rdunlop/uni-timer/easyEDA/schematic.pdf

## MicroSD

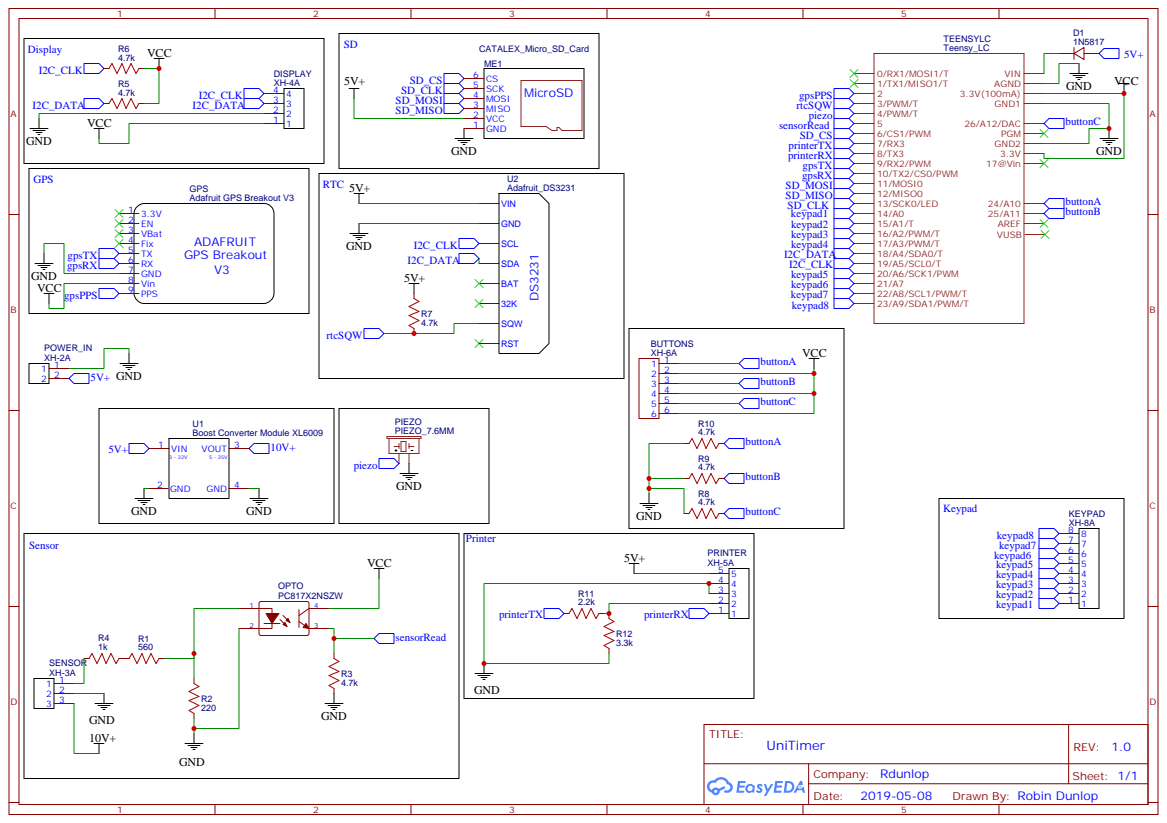
[picture p5: page 1]

Drawn By: Robin Dunlop
