rdunlop/uni-timer/LaserCutBox/Laid out for CuttingTextToPaths.pdf

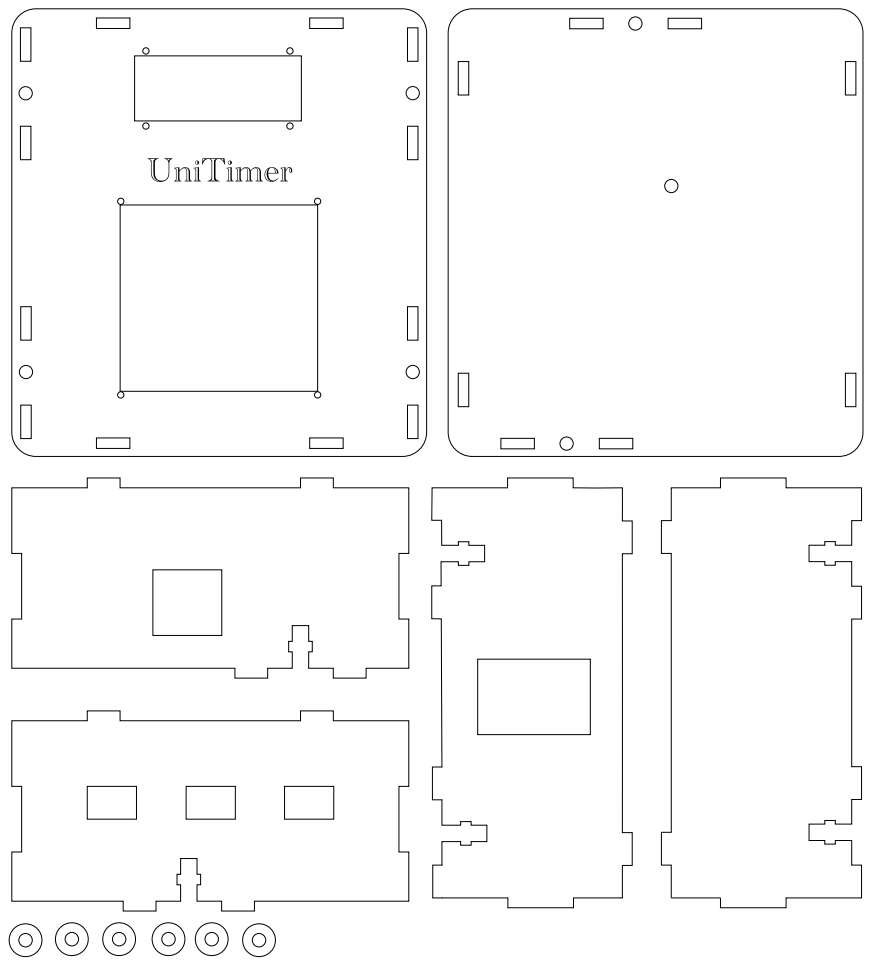
[picture p6: page 1]
