rdunlop/uni-timer/easyEDA/pcb_layout.pdf

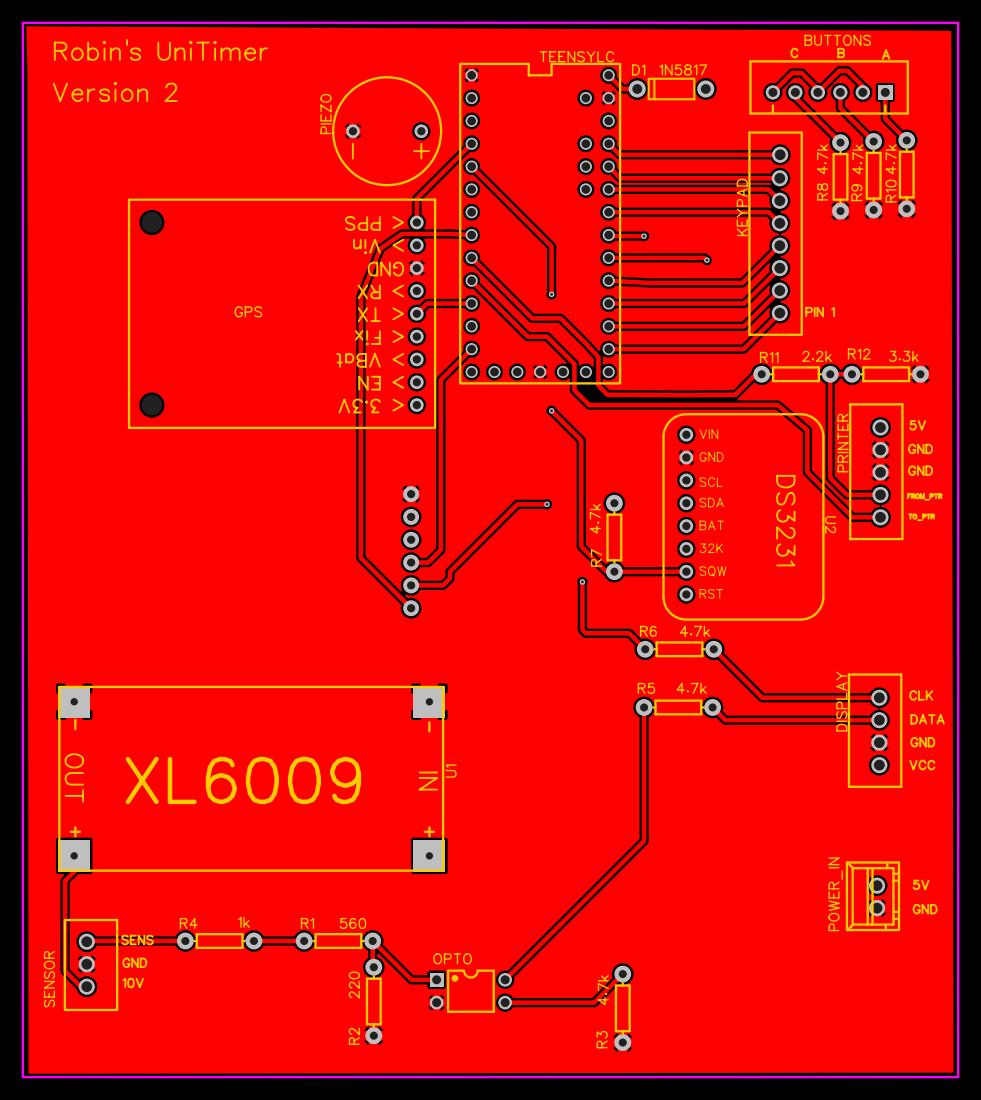
[picture p7: page 1]
