rdunlop/uni-timer/(list of files, drawings)

Other design files:
easyEDA/pcb_layout.json
easyEDA/schematic.json
