rdunlop/uni-timer/rtc.ino

// - RTC
#ifdef ENABLE_RTC
#include "RTClib.h"

RTC_DS3231 rtc;

volatile byte rtc_interrupt_flag = false;
volatile unsigned long rtc_start_ms = micros();

uint32_t last_rtc_print_time = millis();

// RTC SQW signal is an active-low signal, so it needs INPUT_PULLUP
void rtc_interrupt(){
  rtc_interrupt_flag = true;
  Serial.print("RTC: ");
  unsigned long  now = micros();
  Serial.println(now - rtc_start_ms);
  rtc_start_ms = now;
}

void setup_rtc() {
  if (! rtc.begin()) {
    Serial.println("Couldn't find RTC");
    while (1);
  }
  if (rtc.lostPower()) {
    Serial.println("RTC lost power, lets set the time!");
    // following line sets the RTC to the date & time this sketch was compiled
    rtc.adjust(DateTime(F(__DATE__), F(__TIME__)));
  }
  // I don't know if this does anything
  // enable the 1 Hz output
  //rtc.writeSqwPinMode (DS3231_SquareWave1Hz);

  pinMode(RTC_SQW_DIGITAL_INPUT, INPUT_PULLUP);
  attachInterrupt(digitalPinToInterrupt(RTC_SQW_DIGITAL_INPUT), rtc_interrupt, RISING);
}

void loop_rtc() {
  if (rtc_interrupt_flag) {
    digitalWrite(LED_BUILTIN, HIGH);    // flash the led
    delay(100);                         // wait a little bit
    digitalWrite(LED_BUILTIN, LOW);     // turn off led
    rtc_interrupt_flag =  false;                      // clear the flag until timer sets it again
  }

  // if millis() or timer wraps around, we'll just reset it
  if (last_rtc_print_time > millis())  last_rtc_print_time = millis();
  // approximately every 2 seconds or so, print out the current GPS stats
  if (millis() - last_rtc_print_time > 2000) { 
    last_rtc_print_time = millis(); // reset the timer
    printRTC();
  }
}

char daysOfTheWeek[7][12] = {"Sunday", "Monday", "Tuesday", "Wednesday", "Thursday", "Friday", "Saturday"};
void printRTC() {
  DateTime now = rtc.now();

  Serial.println("---------------------------");
  Serial.println("RTC:");
  Serial.print(now.year(), DEC);
  Serial.print('/');
  Serial.print(now.month(), DEC);
  Serial.print('/');
  Serial.print(now.day(), DEC);
  Serial.print(" (");
  Serial.print(daysOfTheWeek[now.dayOfTheWeek()]);
  Serial.print(") ");
  Serial.print(now.hour(), DEC);
  Serial.print(':');
  Serial.print(now.minute(), DEC);
  Serial.print(':');
  Serial.print(now.second(), DEC);
  Serial.println();
  
  Serial.print(" since midnight 1/1/1970 = ");
  Serial.print(now.unixtime());
  Serial.print("s = ");
  Serial.print(now.unixtime() / 86400L);
  Serial.println("d");
  
  // calculate a date which is 7 days and 30 seconds into the future
  DateTime future (now + TimeSpan(7,12,30,6));
  
  Serial.print(" now + 7d + 30s: ");
  Serial.print(future.year(), DEC);
  Serial.print('/');
  Serial.print(future.month(), DEC);
  Serial.print('/');
  Serial.print(future.day(), DEC);
  Serial.print(' ');
  Serial.print(future.hour(), DEC);
  Serial.print(':');
  Serial.print(future.minute(), DEC);
  Serial.print(':');
  Serial.print(future.second(), DEC);
  Serial.println();
  
  Serial.println();
}

#endif
