rdunlop/uni-timer/mode_fsm.h

#pragma once

#define MODE_OFFSET 100
#define MODE_1 101
#define MODE_2 102
#define MODE_3 103
#define MODE_4 104
#define MODE_RESUME_5 105
#define MODE_RESUME_6 106
#define MODE_5 107
#define MODE_6 108
#define MODE_GPS_LOCK 109
