rdunlop/uni-timer/modes.h

#pragma once

void mode1_loop();

void mode2_loop();

void mode3_loop();

void mode4_setup();
void mode4_loop();
void mode4_teardown();

void mode5_fsm_setup();
void mode5_setup();
void mode5_loop();
void mode5_teardown();

void mode6_fsm_setup();
void mode6_setup();
void mode6_loop();
void mode6_teardown();

void mode_resume_setup();
void mode_resume_loop();
void mode_resume_teardown();
