rdunlop/uni-timer/(commit log)

2019-05-04 Add Printer, make led blink on sensor read
2019-05-18 Many changes for supporting the full-pin-layout
2019-05-20 Fix Keypad library extraction
    [UniTimer.ino, uni_keypad.cpp, uni_keypad.h]
2019-05-20 extract printer class
2019-06-09 invert the display pinout. Clean up loop codes
    [UniTimer.ino, uni_gps.cpp, uni_gps.h, uni_keypad.cpp, uni_keypad.h, uni_sd.cpp]
2019-06-30 Add lots of display-related code/fixes
    [UniTimer.ino, uni_display.cpp, uni_display.h, uni_keypad.cpp, uni_keypad.h, uni_sd.cpp]
2019-07-01 Create method to read current time, including milliseconds.
2019-07-04 add more FSM code Able to transition to 'sensor ready' mode.
2019-07-04 show racer number and time on printer when in Mode 5
2019-07-05 Attempt to fix the mode-change stuffs
    [UniTimer.ino, uni_keypad.cpp]
2019-07-06 Fix mode-selection with multi-key logic
    [UniTimer.ino, uni_display.cpp, uni_keypad.cpp, uni_keypad.h]
2019-07-07 Use interrupt handler for monitoring sensor trip
2019-07-07 Make keypad wait 20 seconds before calling a button press a 'hold'
2019-07-07 Write to SD card when sensor is tripped
2019-07-10 fix re-initialization of fsm transitions
    [UniTimer.ino, mode5.cpp, modes.h]
2019-07-10 Create an accurate timer, and cache the hour/minute/second/ms when sensor is tripped
2019-07-10 debounce interrupt instead of calling delay()
2019-07-10 Change to have a different data format for the SD and the printer
2019-07-10 Make A/B/C/D* buttons consistent, and eliminate unneeded states in mode5
2019-07-10 Print the filename when entering recording mode
2019-07-10 Fix problem where sensor would be tripped 2x in the same 0.5 seconds because we clear the time once we deal with it
    [accurate_timing.cpp, mode6.cpp]
2019-07-11 Fix filename buffer-overflow, also fix delete-single-entry in mode6
    [mode2.cpp, mode5.cpp, mode6.cpp, recording.cpp, recording.h, uni_gps.cpp]
2019-07-11 Clear display when deleting current racer entry on sensor mode (mode 5)
2022-03-07 Update README with plans for version 2.1.
    Also update code and instructions for use with Teensyduino development system.
    Also add easyEDA files/pdf
    [pcb_layout.json, schematic.json]
2022-03-07 Remove thermal printer code
2022-03-10 fix ability to write/read/resume from config file.
    Also rework the display.waiting() function into an FSM to eliminate delay(),
    which was preventing UI responsiveness
    [UniTimer.ino, mode4.cpp, mode5.cpp, mode_resume.cpp, modes.h, uni_config.cpp, uni_config.h, uni_display.cpp]
2022-03-14 Display free memory every 10 seconds, fix mode transition
    [UniTimer.ino]
2022-03-14 fix ability to transition OUT of mode 5/mode6
    [UniTimer.ino]
2022-04-17 initial LaserCutBox
2022-04-17 fix start-line countdown when fault occurs
    [mode5.cpp]
2022-04-22 Rework the core timing system so that it can deal with loss-of-gps-lock.
    Before this change, if we lost GPS lock, the second wouldn't increment
    [UniTimer.ino, accurate_timing.cpp, accurate_timing.h, mode2.cpp, uni_gps.cpp, uni_gps.h]
2022-04-22 change from using micros() to millis().
    micros() overflows every 70 minutes, millis, only after 49 days of uptime
2022-04-23 fix interrupt check (was ignoring all crossings). Add ability to see previous milliseconds by pressing *
    [UniTimer.ino, accurate_timing.cpp]
2022-06-14 update lasercut box
2022-06-15 Add new PDF of lasercut box, update README with new learnings
2022-06-26 Update LaserCut Readme
2022-06-27 Allow up to 20 stored results at finish line.
    Also fix some warnings, and fixup some readme texts
    [mode2.cpp, mode6.cpp, recording.cpp, uni_display.cpp]
2022-06-27 When GPS date changes, make hour 24+current-hour,
    this prevents the time from losing time if a race crosses the gps date boundary
    [uni_gps.cpp, uni_gps.h]
2022-06-27 Update buzzer tones for start to match the ski-common-tones.
    We tuned this by hand/ear.
    [uni_buzzer.cpp]
2022-06-27 Display error if problem writing to SD card.
    Fix ability to write/read from SD card after it has been removed/reinserted
    [mode5.cpp, mode6.cpp, recording.cpp, recording.h, uni_sd.cpp]
2022-06-27 Make failure-tone bee-doo (descending)
    [uni_buzzer.cpp]
2022-06-30 fix ability to duplicate entry
    [mode6.cpp]
2022-07-05 Rework mode 6.
    Note: this appears to break the duplicate-results functionality
    [mode6.cpp]
